courtois-neuromod/controller/README.md

# Game controller for fMRI



This document describes how to build the MR compatible videogame controller developed for the [Courtois Neuromod project](https://www.cneuromod.ca/).

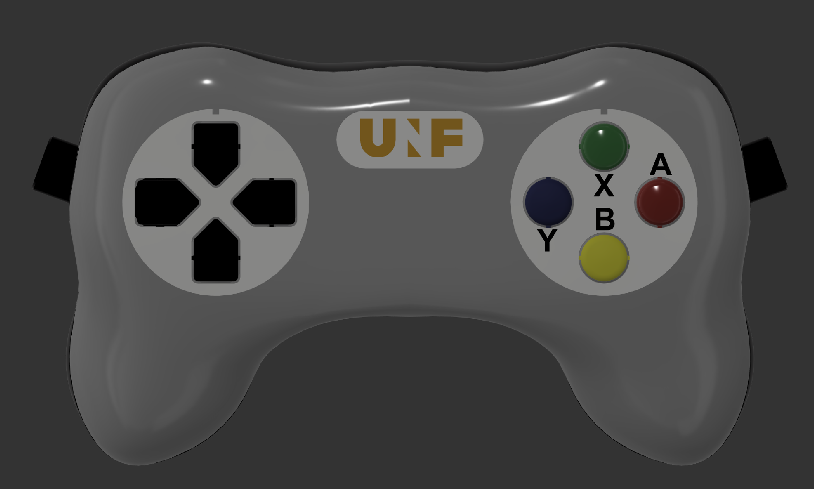
[picture p1: source/_static/body/controller_model.png]
Switch assembly exploded view
