courtois-neuromod/controller/source/BODY.md

# Building the controller body

This document describes the steps necessary to build and assemble the hand-held controller body part.

## Assembly

### Optical switches

#### Shutter assembly

Required:

Parts
  - Shutter_Blade x 8
  - Shutter_Cap x 8
  - Switch_Body x 8

Tools
  - Cyanoacrylate adhesive
  - Fine sanding paper or files
  - X-acto knife

Check both shutter blade and shutter cap for smoothness of surface and file or sand any rough surface. Test insertion of blade into slot at the bottom of shutter cap. It should slide to the bottom easily but you should still feel a bit of resistance. Put a drop of cyanoacrylate adhesive on a liquid tight surface, dip the end of shutter blade in adhesive and insert into slot at bottom of shutter cap.

Shutter assembly drawing | Shutter assembly exemple
---|---
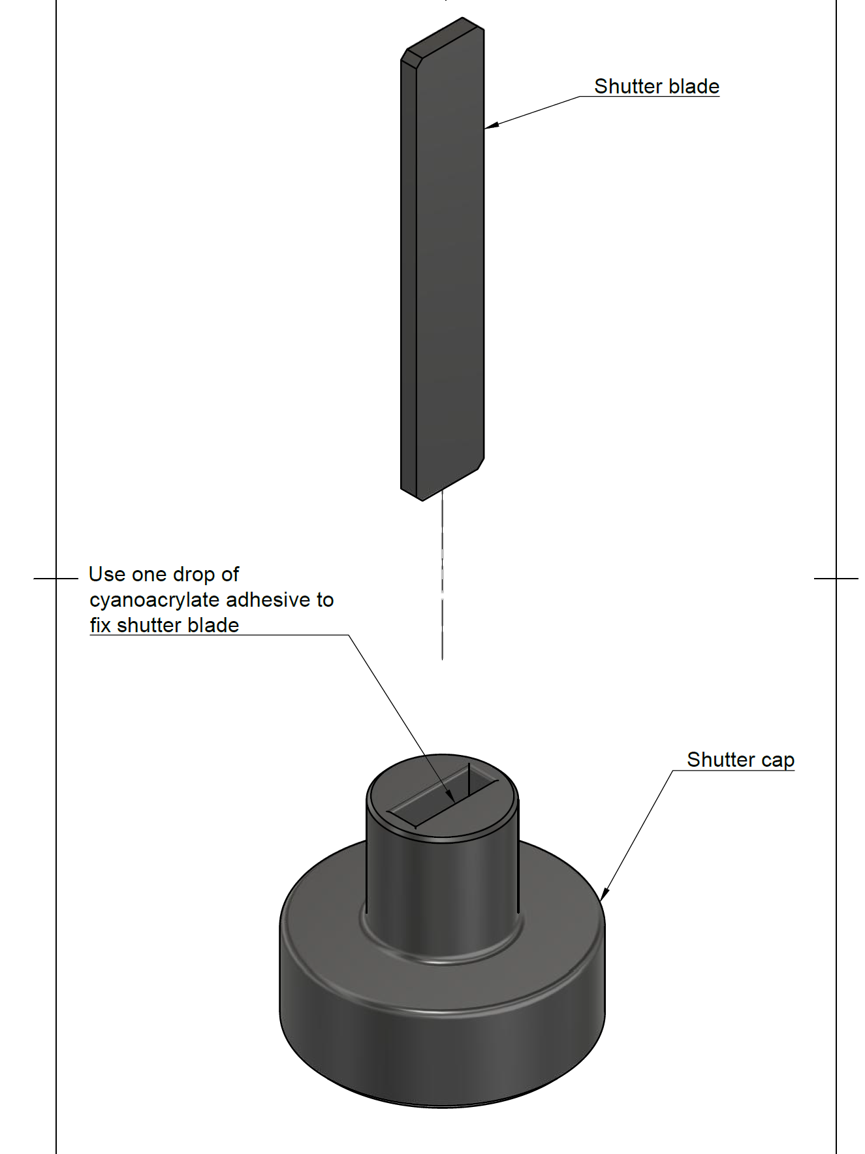
[picture p15: source/_static/body/Shutter_Assembly.png]
Switch assembly exploded view
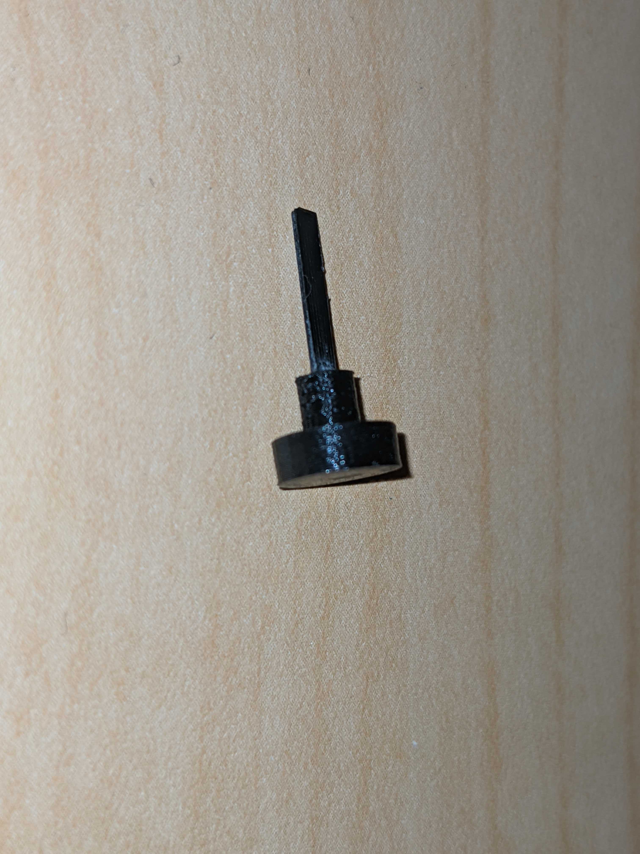
[picture p16: source/_static/body/Shutter_Assembly_demo.jpg]
Switch assembly exploded view
 |

#### Switch assembly

1. Disassemble a discarded computer keyboard to recuperate the membrane making the rubber dome switches. Individually cut away the switch dome parts and remove centre of top surface using an x-acto knife.

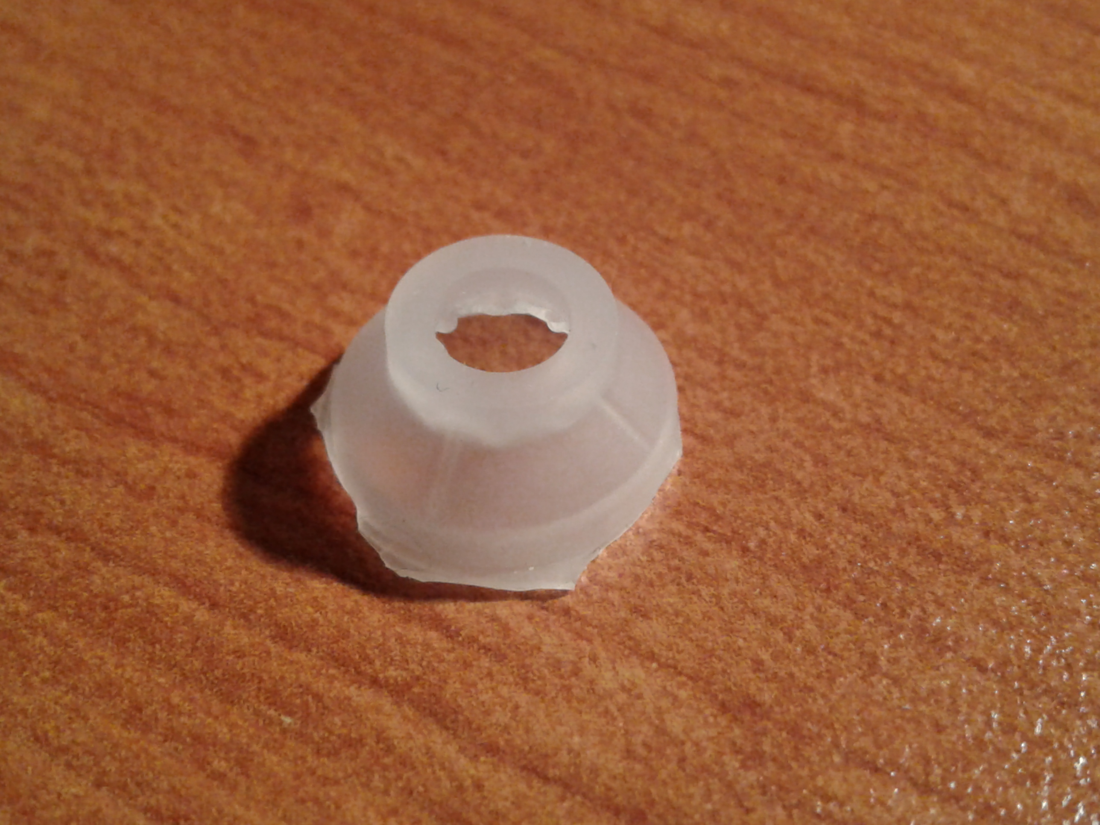
[picture p17: source/_static/body/silicone_membrane.jpg]
Silicone membrane


2. Test assembly of shutter, membrane and switch body by inserting the shutter blade into the empty centre part of rubber dome, then into gap at the top of switch body. The shutter blade should completely occult the guide hole for the fiber optic when button is pressed down, but leave it free when in upward position. The distance between the bottom
 of the shutter cap and the top of switch body will determine the stroke length of the key. The smaller this distance, the more responsive the controls will be. The shutter should move freely up and down.

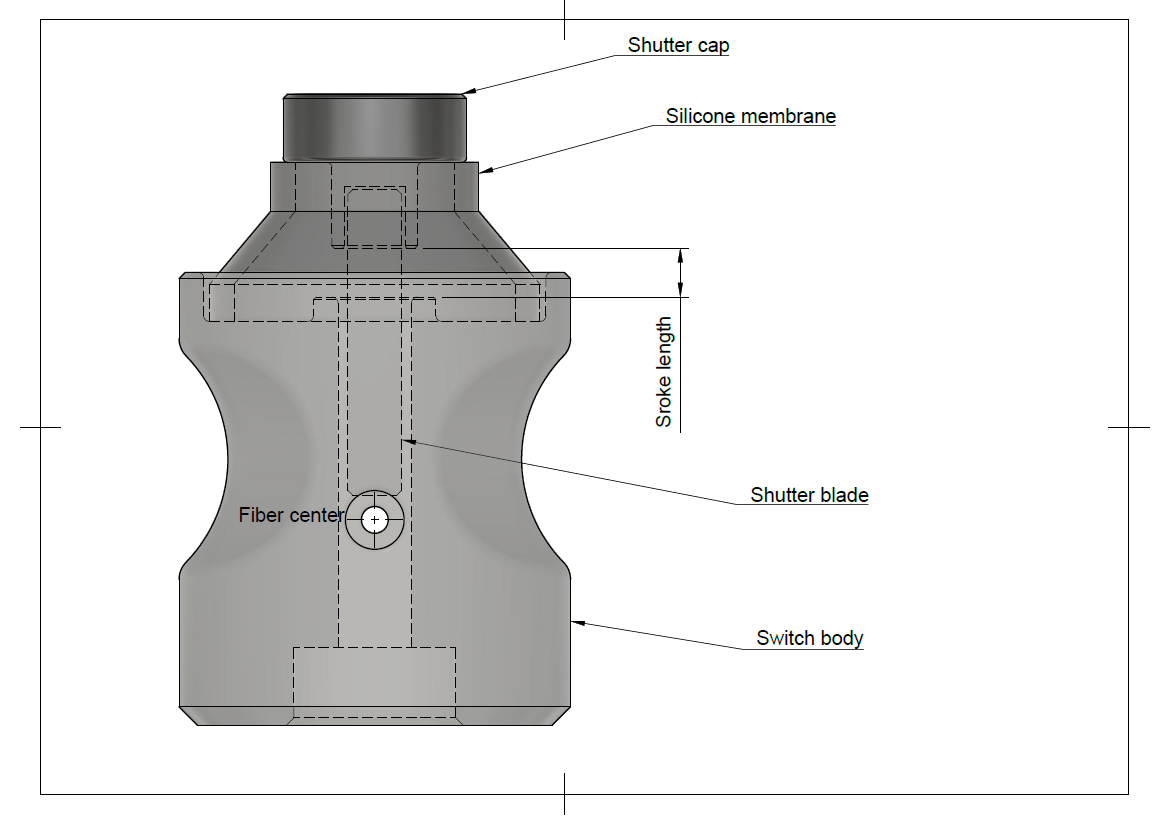
[picture p18: source/_static/body/Switch_Assembly_Drawing.png]
Air Gap Visual Check
 

 Shutter up | Shutter pressed down
 ---|---
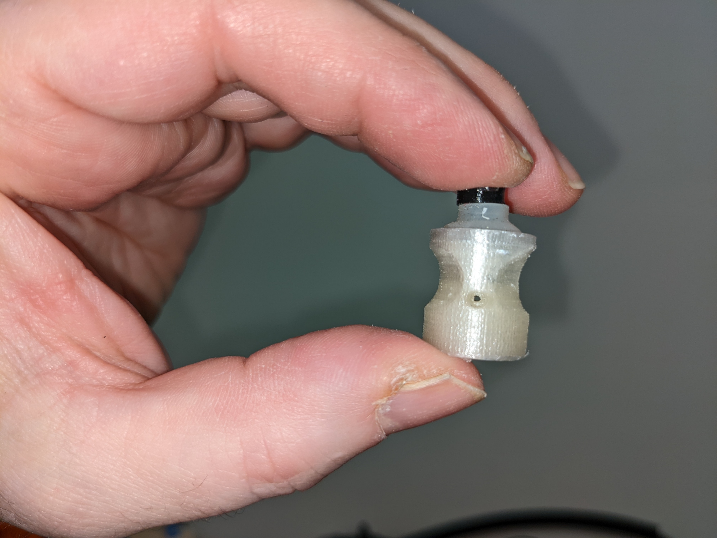
[picture p19: source/_static/body/PXL_20220321_143415461.jpg]
Shutter up
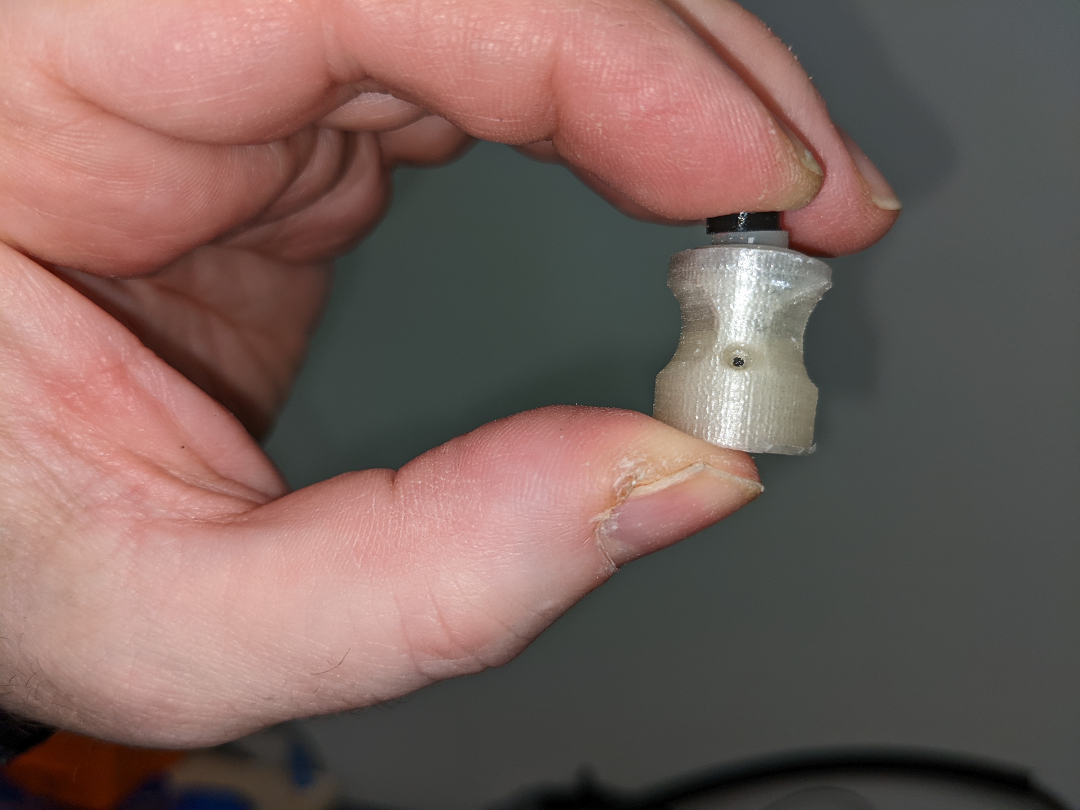
[picture p20: source/_static/body/PXL_20220321_143421189.jpg]
Shutter down
  |

 3. Since the rubber domes recuperated from computer keyboards will very likely vary in dimensions, it might be necessary to modify shutter cap and shutter blade dimensions. The file [Shutter_Assembly_Param.f3d](CAD/f3d/Shutter_Assembly_Param.f3d) contains these two parts in Autodesk Fusion 360 format. The design is parametric to facilitate modifications. To edit the parts, open the file in **Fusion 360**, go to Modify, then select change parameters and expand User Parameters. Changing the value of parameter *Shutter_Cap_Shaft_Length* will allow to adjust the stroke length, while changing *Shutter_Blade_L* will allow ensuring correct shutter operation. That part is also available in [.step](/CAD/stp/Shutter_Cap.step) format for import in other CAD programs.

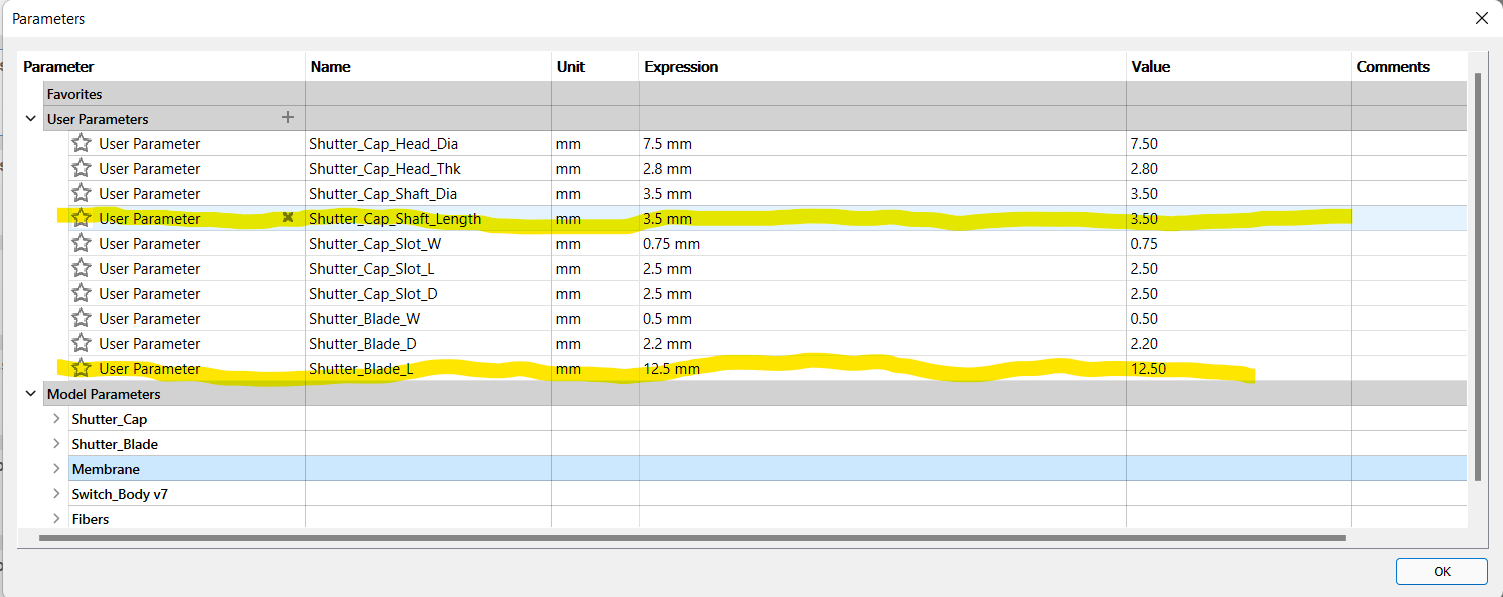
[picture p21: source/_static/body/f3d_screenshot.png]
Parameters edit in Fusion 360
<br>

4. Ensure that the air gap and the fiber optic guide in the 3D printed switch bodies are free of any residual PLA or support material. Hold switch body in front of a light source and check along Z axis for the air gap, and along horizontal axis for the fiber optic guide.

### Controller body

1. For each control on the controller, cut one length of duplex fiber optic to desired length between controller and interface module + 150 mm
2. Split each length of fiber on its length to separate the 2 fibers on a distance of approx. 750 mm from one end, and 25 mm from second end
3. Label each fiber with the name of matching control. On the end where the fibers are split for the largest distance (controller end) place a label on each single fiber
4. On the controller side of the fibers, make two bundles of fibers. Place one fiber of eac78h control in either bundle.
5. For one of the two bundles, cut the fibers for the directional pad controls about 150 mm shorter than the ones for the buttons. Do the opposite with the other bundle. This will allow a cleaner layout of the fibers inside the casing.
6. Strip and polish fibers
7. Cut two 500 mm lengths of the 13 mm ID plastic hose and fix those on the ends of the Y splitter
8. Fix second end of plastic hoses to extrusions on part *Casing_Bottom*

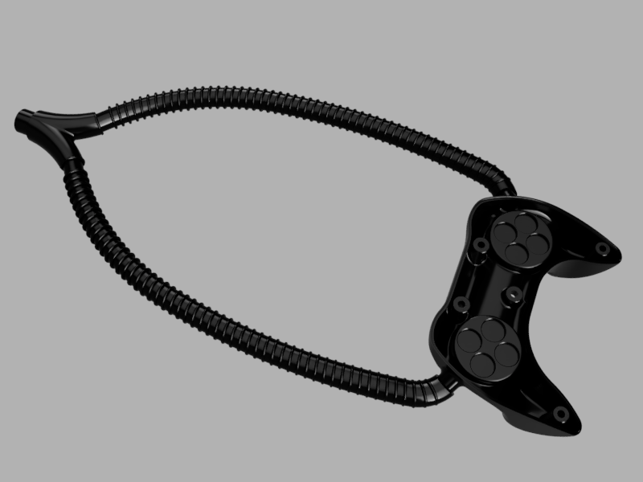
[picture p22: source/_static/body/Fiber_Sheath_Assembly.png]
Fiber_Sheath_Assembly


Fiber_Sheath_Assembly

9. For each control, place a *Switch_Body* in matching groove inside casing.

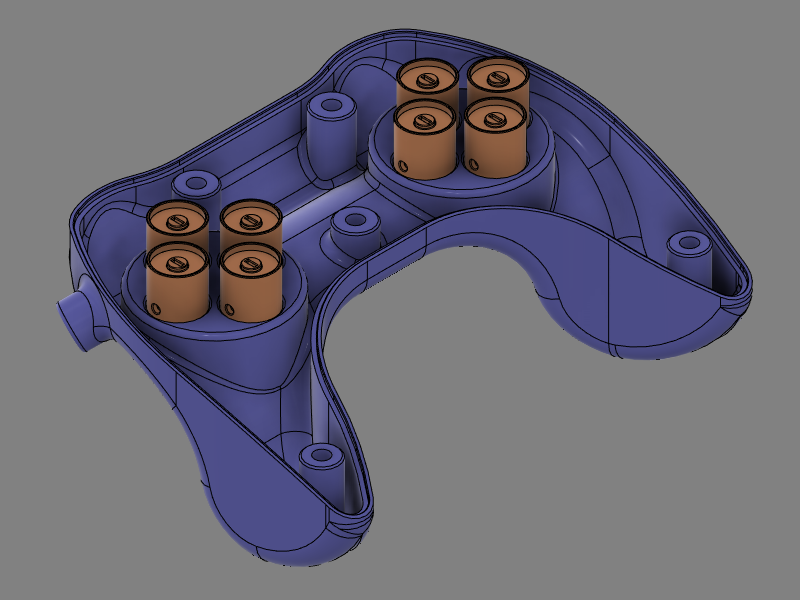
[picture p23: source/_static/body/Switch_Body_Positioning.png]
Switch_Body_Positioning


10. Insert the fiber optics into Y splitter and push gently until both fibers emerge inside of casing. The bundle where the buttons fibers are longer will go on the directional pad side. There will be one fiber for each control in each branch of the Y. Make sure that the length protruding inside the casing is enough to reach into the corresponding *Switch_Module* and allow to lay out cleanly inside casing.
11. For each control, glue both fibers in place **(Need glue specs)**
12. Optional: Depending on fit tightness of *Switch_Module* parts inside grooves, it is also possible to glue the module in place. If gluing modules in place, wait for glue on fibers to set before proceeding
13. Place one threaded Nylon insert in each mounting post of part *Casing_Top*. If inserts don't fit inside, re-drill hole using 1/4" (6.35 mm) bit. If inserts are loose, use a drop of cyanoacrylate adhesive

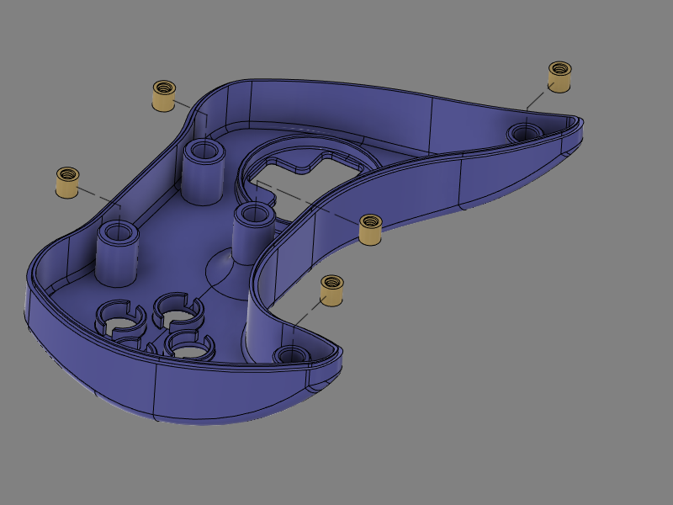
[picture p24: source/_static/body/Threaded_Inserts.png]
Threaded_Inserts
<br>

14. Before starting assembly, test bottom and top parts of casing for fit. The two halves should fit together without any visible gap. Common area that might need post processing are the top and bottom of screw posts and the lip that runs around the perimeter of the bottom part, as well as the matching flat surface on the top part. If necessary, file or sand away excess of material that might prevent case from closing properly.

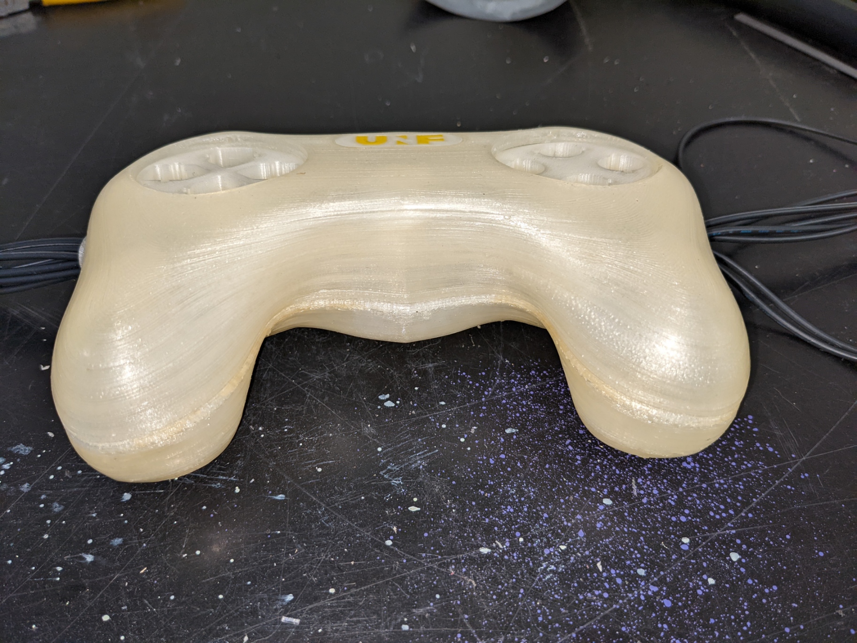
[picture p25: source/_static/body/PXL_20220323_120717804.jpg]
<br>
Test casing for fit

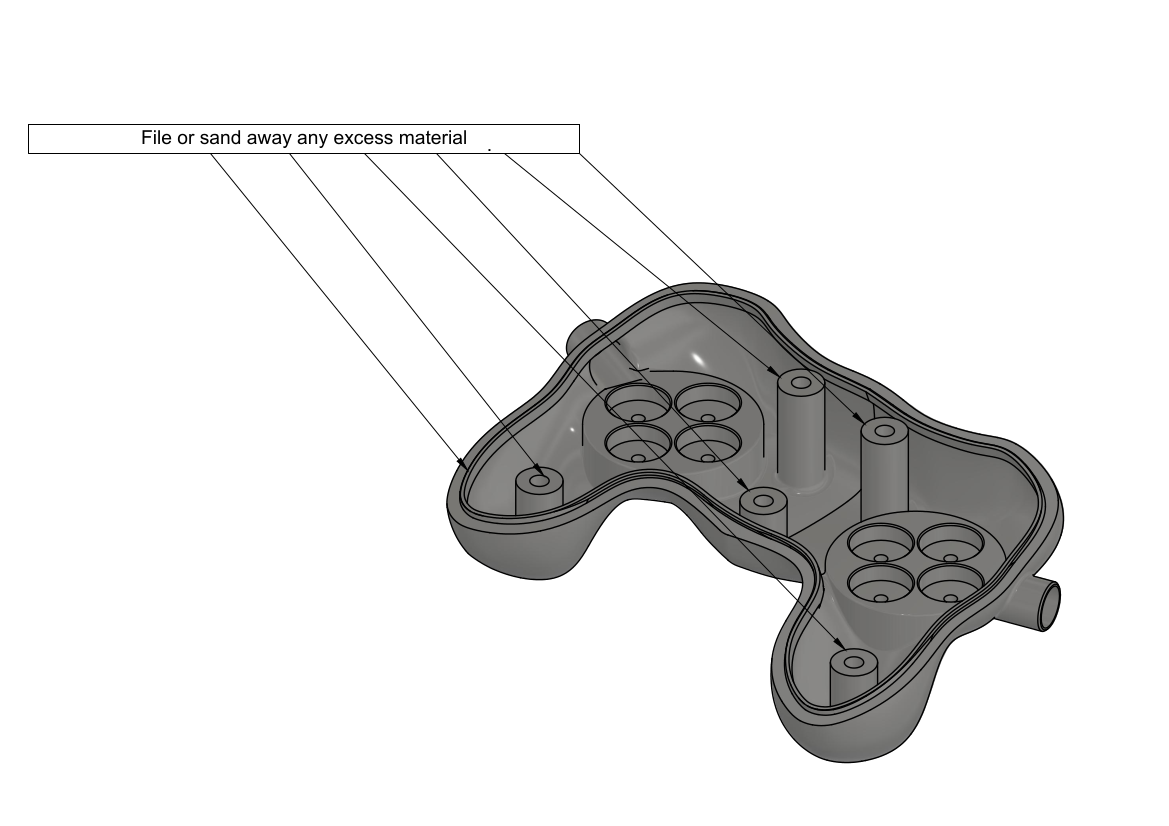
[picture p26: source/_static/body/PostProcess_Bottom.png]
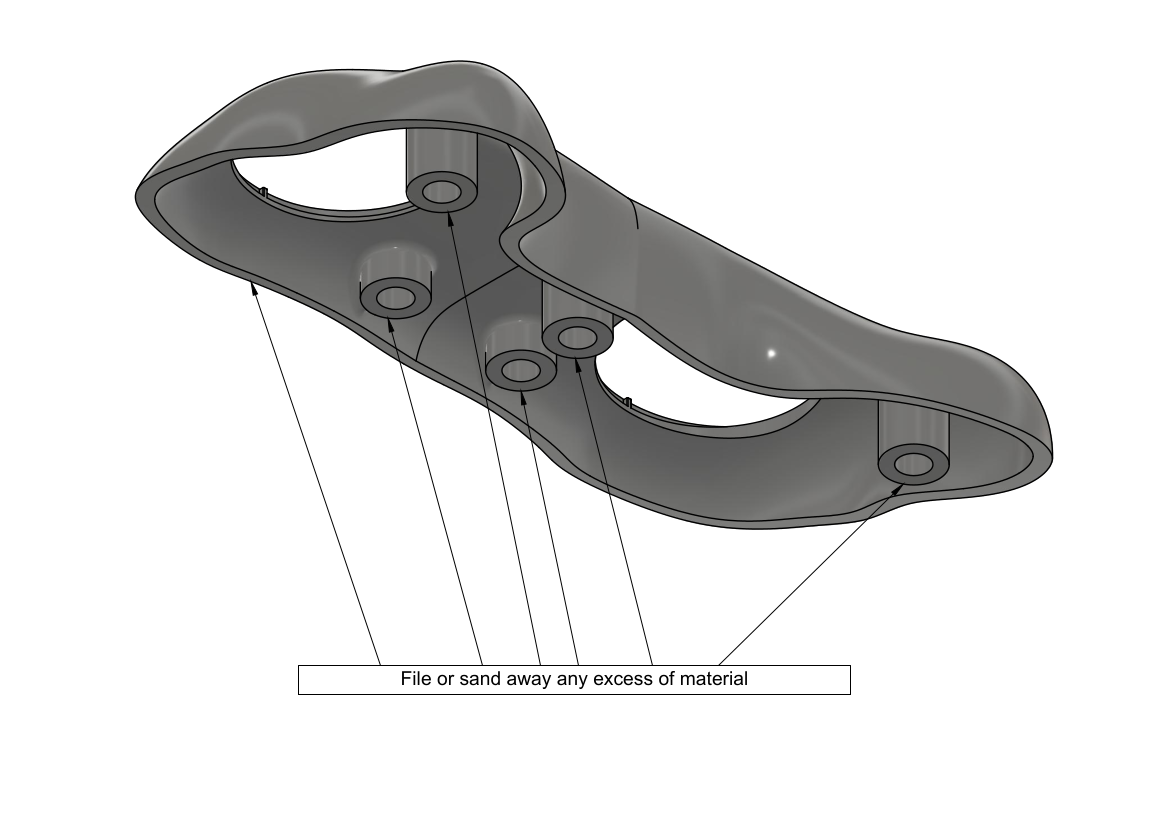
[picture p27: source/_static/body/PostProcess_Top.png]
 |  <br>
Areas commonly requiring post-processing

### Optical fibers assembly
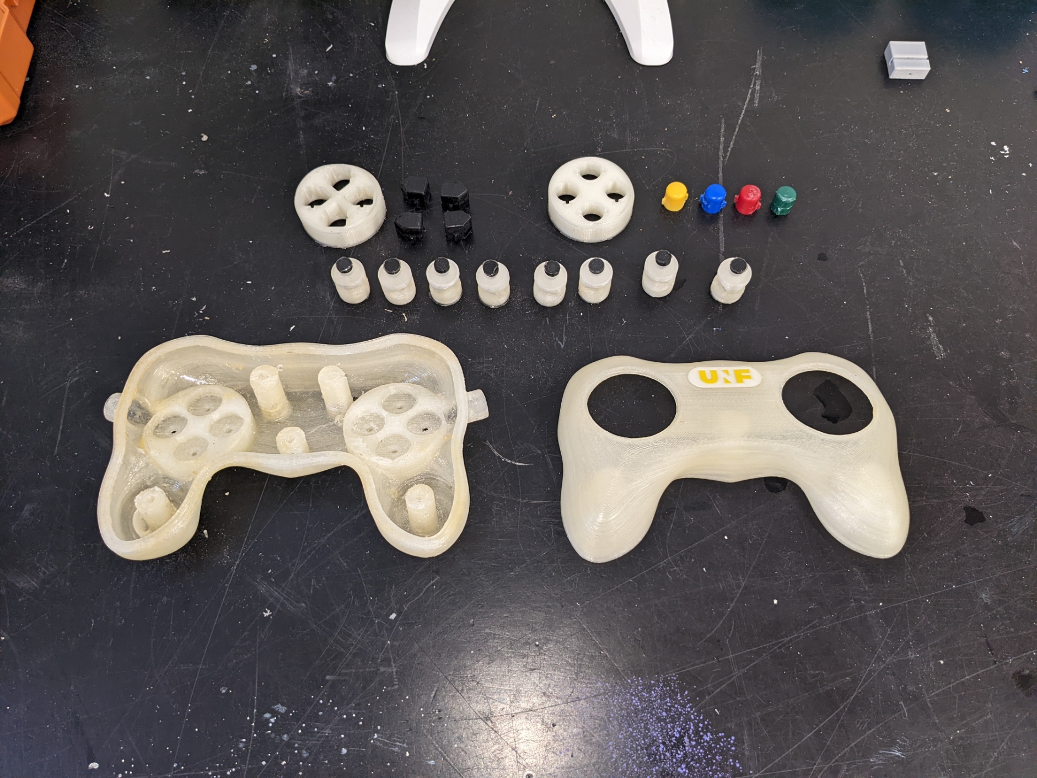
[picture p28: source/_static/body/PXL_20220318_175520012.jpg]
<br>
Parts ready for assembly

1. Separate bundle of fiber optics into two smaller bundles of 8 fibers each. Pull each smaller bundle through the Y splitter with one small bundle coming out of each of the Y branches. Pull each of the smaller bundle into the 1 meter protective sheath until there is approximately 300 mm of fibers coming out of each sheath.

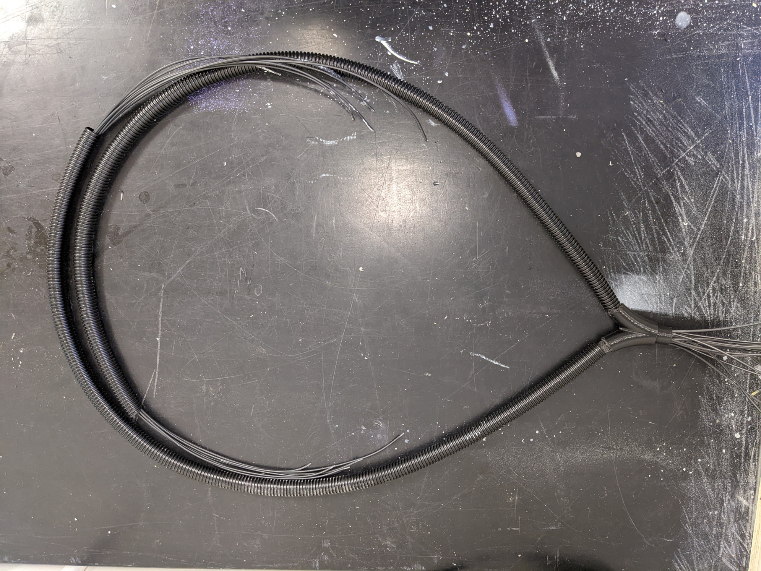
[picture p29: source/_static/body/PXL_20220321_141826371.jpg]
<br>
Separating fibers bundle with Y splitter

2. Pull each bundle into the bottom part of casing through openings on the sides and make sure that the sheaths fit nicely on the protruding parts and that you have at least 200 mm length of fibers going into the casing on both sides.

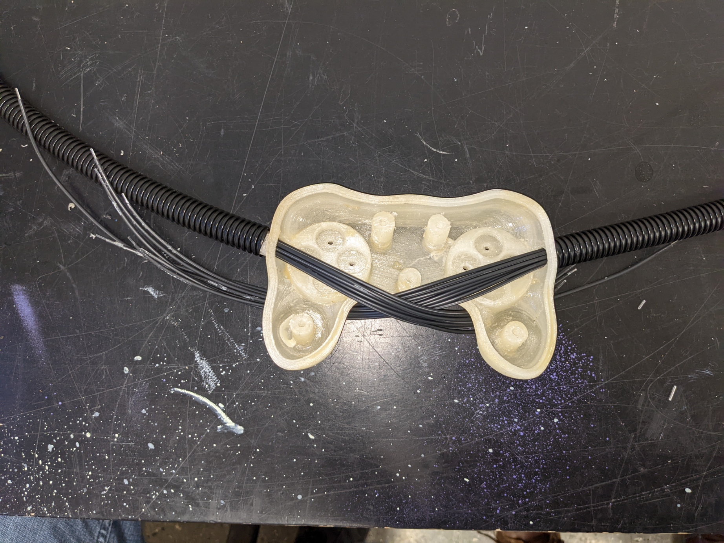
[picture p30: source/_static/body/PXL_20220321_142636964.jpg]
<br>
Fibers insertion in casing

3. Strip fibers and polish the fibers. It's possible to use a regular wire stripping tool set for #18 wire size. Insert fibers into switch body so teh tip of the fiber is flush with the internal wall of the air gap. Ensure that the shutter is free to move after the fibers are in place.
4. Use a drop a glue to affix the fibers to the switch body. The type of glue is not critical, but **do not use** cyanoacrylate or other type of _permanent_ glue. These will work, but they will make the switch impossible to repair, which means in case of a broken fiber or other problem, you will need to replace the whole switch.

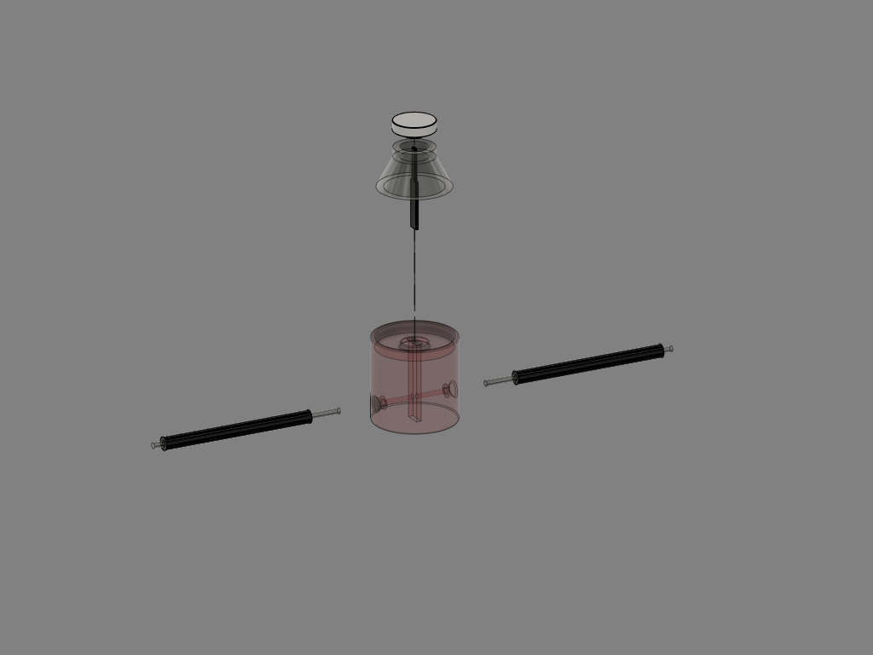
[picture p31: source/img/Switch_exploded.png]
</br>

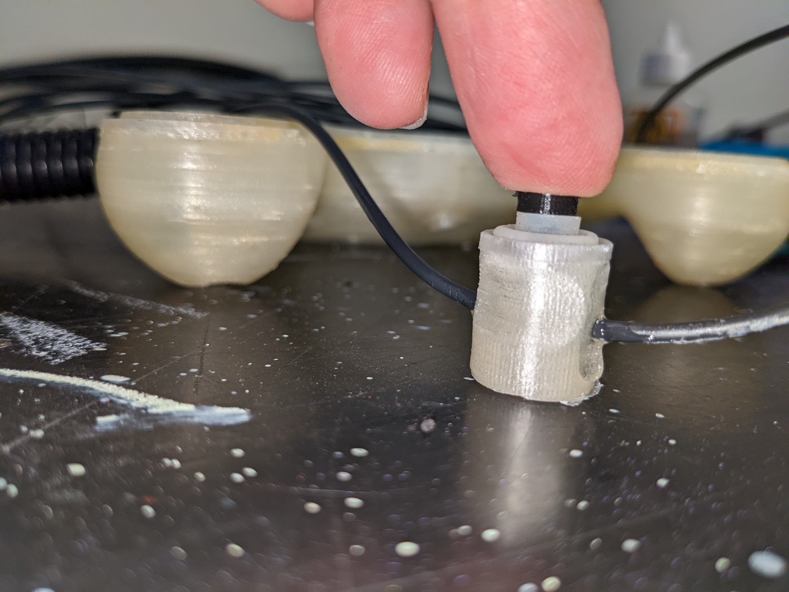
[picture p32: source/_static/body/PXL_20220321_144134479.jpg]
<br>
Fibers connections and testing

5. To assemble the switch inside the casing, it is easier to proceed by pairs, waiting for the glue on the fibers to set before proceeding to the next pair. Proceeding that way allows to move the fibers around to route them cleanly inside the casing without pulling them out from the body of already installed switches. The order is not critical, but it is a lot easier to finish with the pair that's the closest to the opening where the fibers enter the casing.

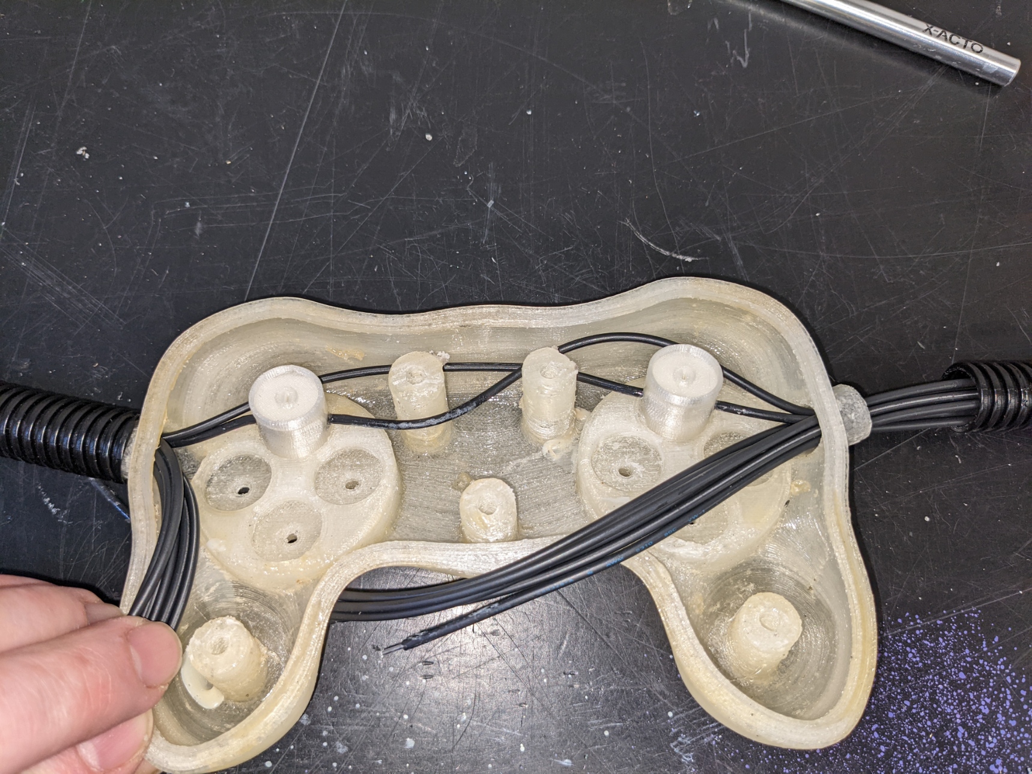
[picture p33: source/_static/body/PXL_20220321_184922653.jpg]
<br>
Assembling first pair of controls

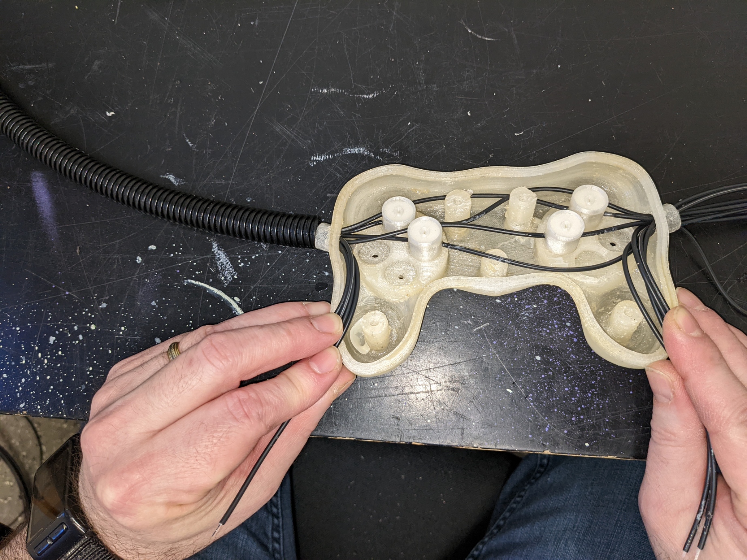
[picture p34: source/_static/body/PXL_20220322_141919955.jpg]
<br>
Assembling second pair of controls

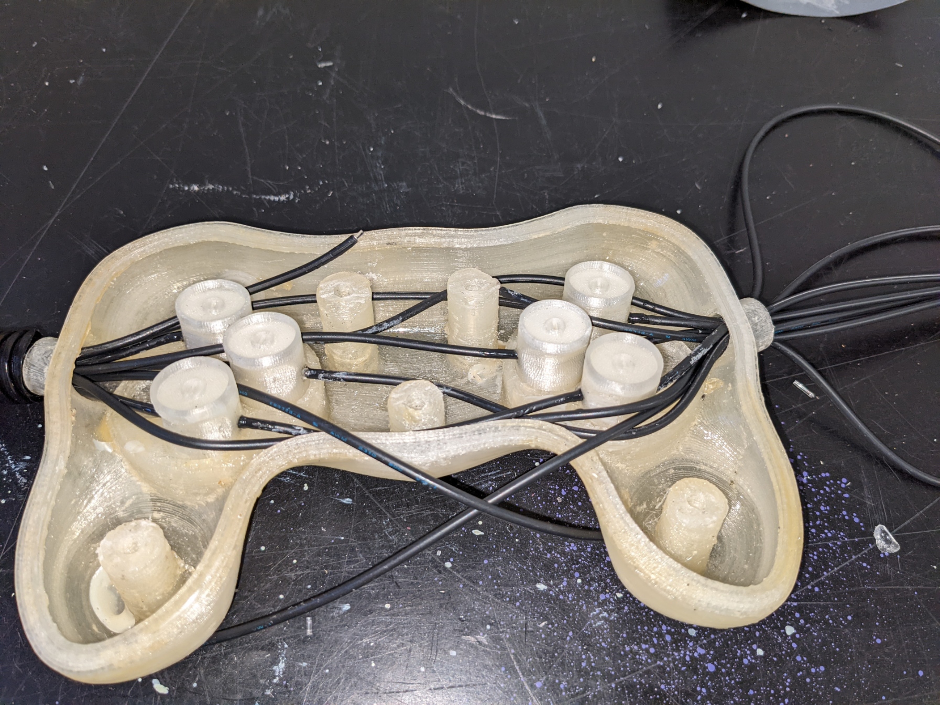
[picture p35: source/_static/body/PXL_20220322_173830800.jpg]
<br>
Assembling third pair of controls

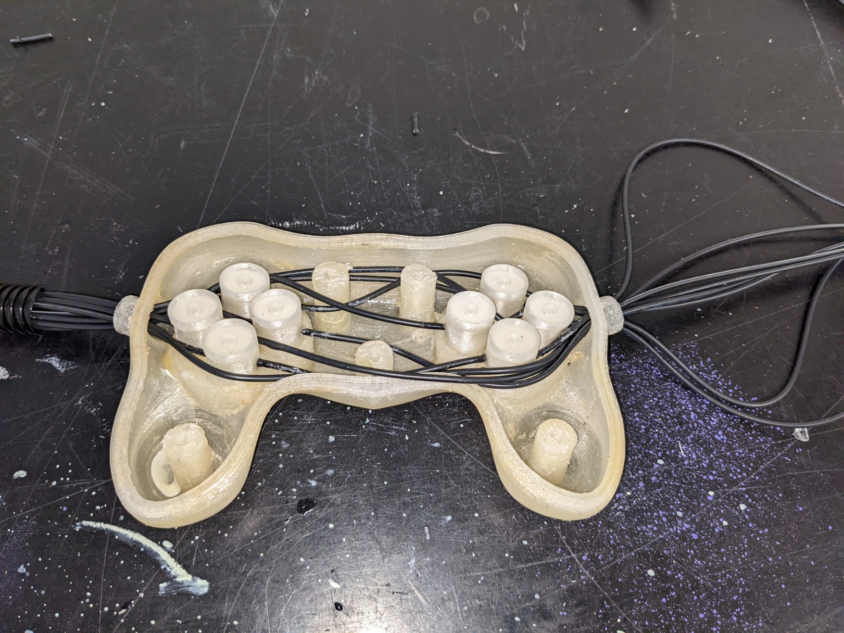
[picture p36: source/_static/body/PXL_20220323_120356872.jpg]
<br>
Assembling fourth pair of controls

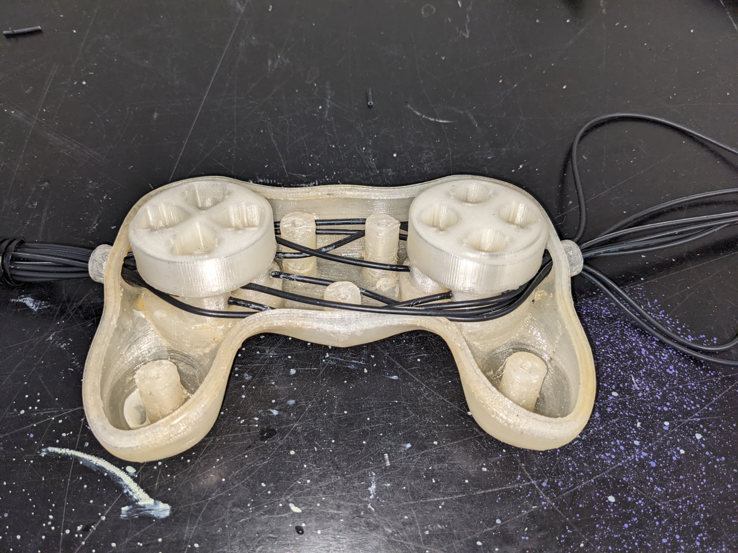
[picture p37: source/_static/body/PXL_20220323_120503073.jpg]
<br>
Add buttons supports

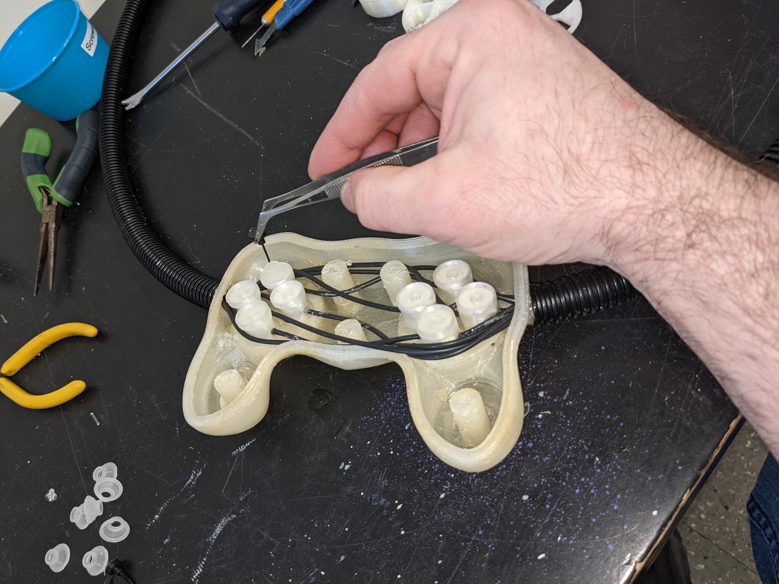
[picture p38: source/_static/body/PXL_20220323_171028876.jpg]
<br>
Installing rubber membranes and shutters

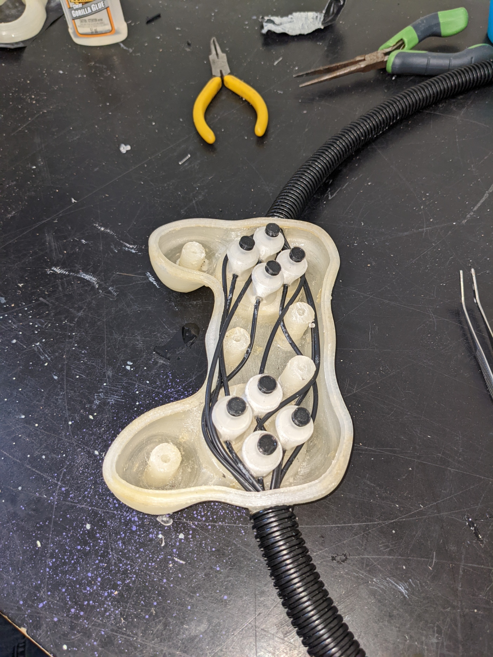
[picture p39: source/_static/body/PXL_20220323_171327664.jpg]
<br>
Finished view

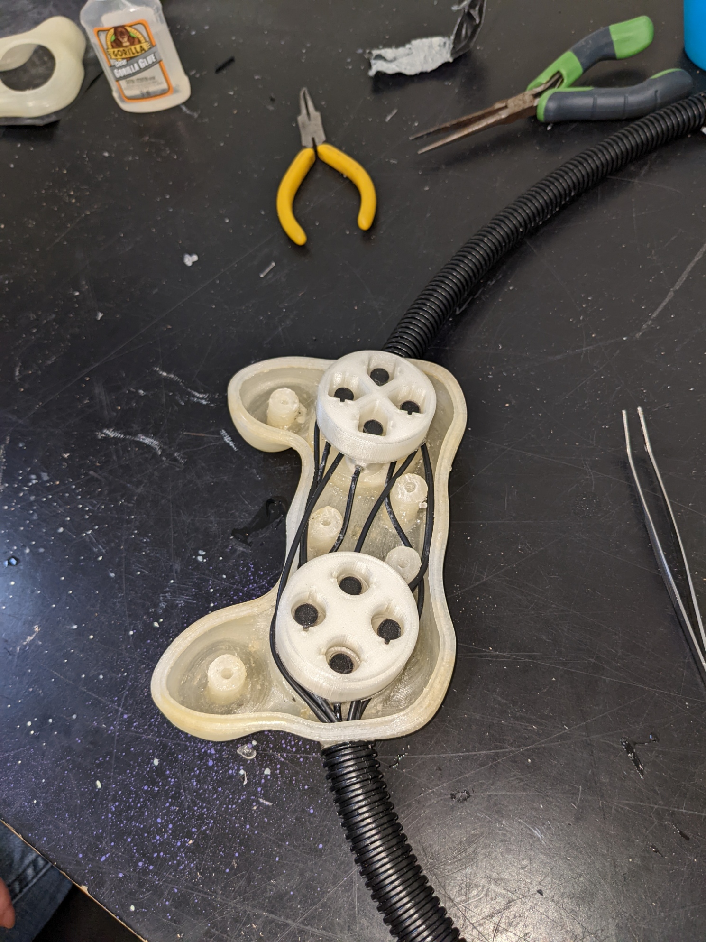
[picture p40: source/_static/body/PXL_20220323_171418885.jpg]
<br>
Re-install buttons supports

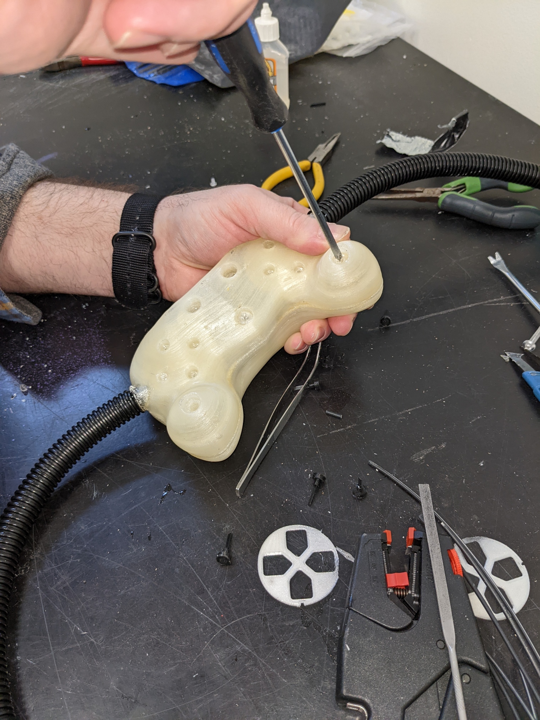
[picture p41: source/_static/body/PXL_20220323_171550344.jpg]
<br>
Close casing

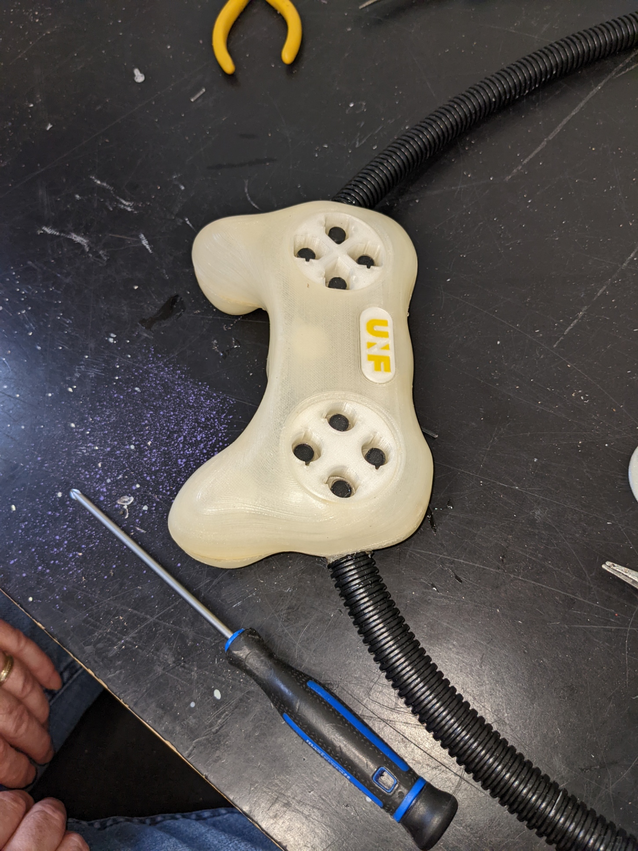
[picture p42: source/_static/body/PXL_20220323_172005029.jpg]
<br>
Casing closed top view

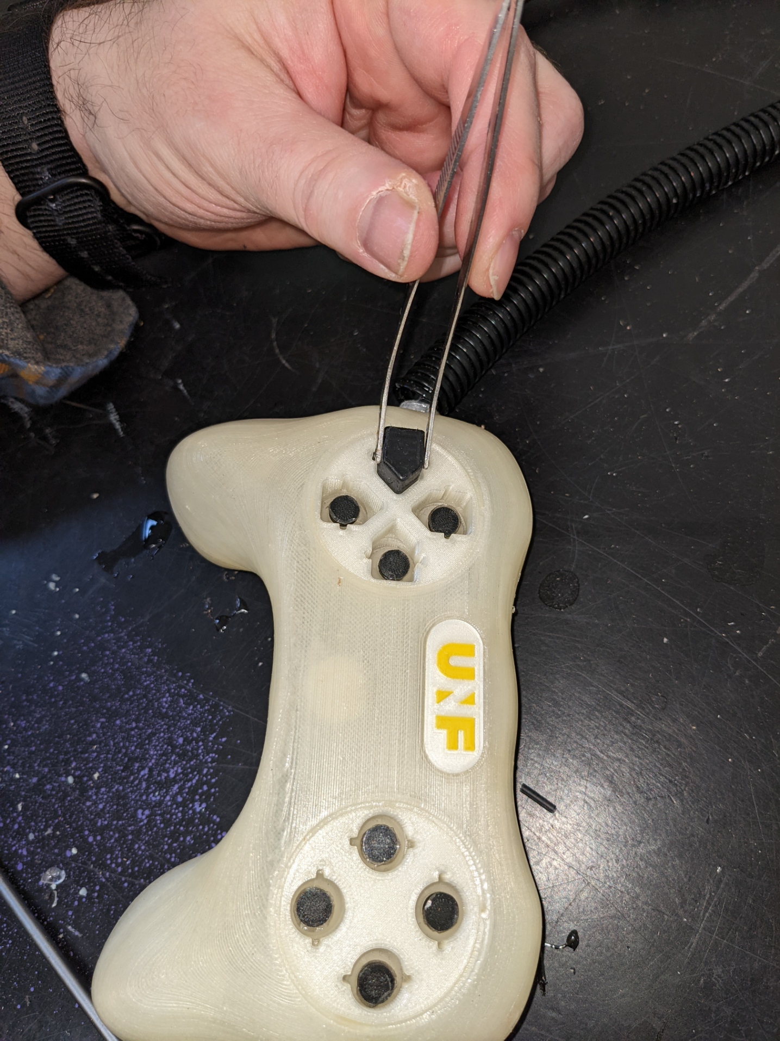
[picture p43: source/_static/body/PXL_20220323_172037025.jpg]
<br>
Install buttons

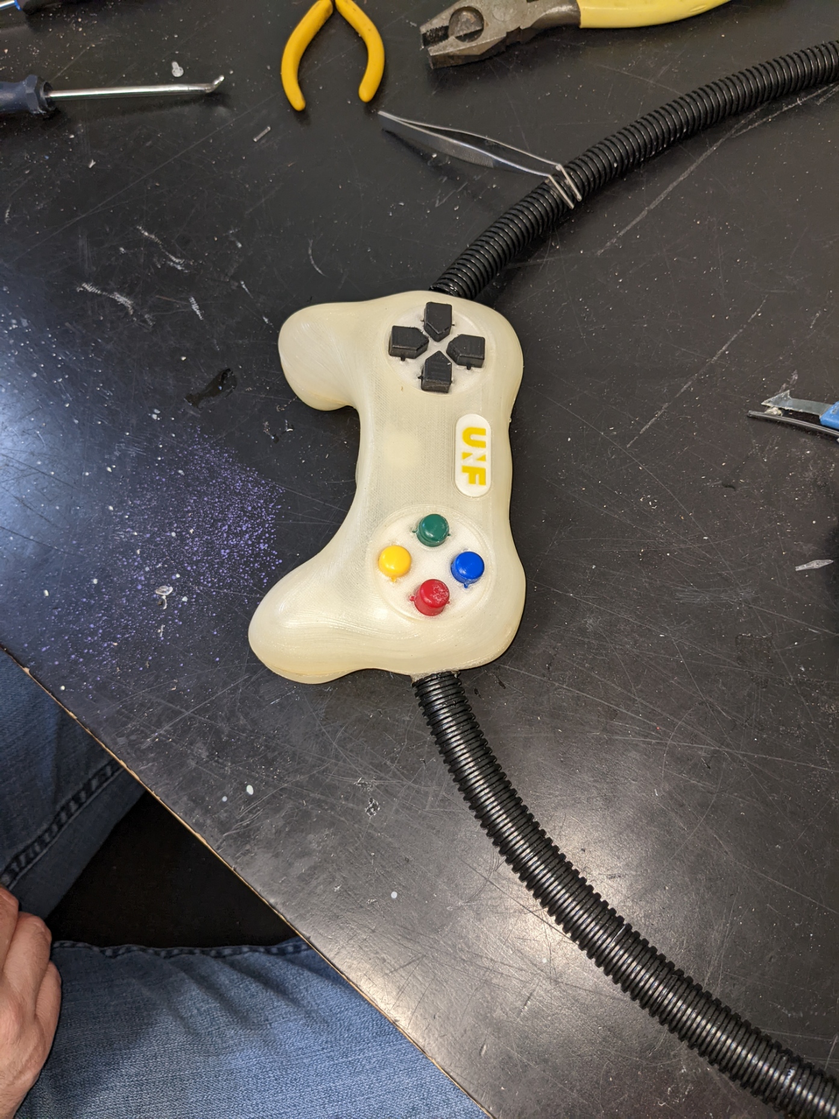
[picture p44: source/_static/body/PXL_20220323_172241888.jpg]
<br>
Finished view

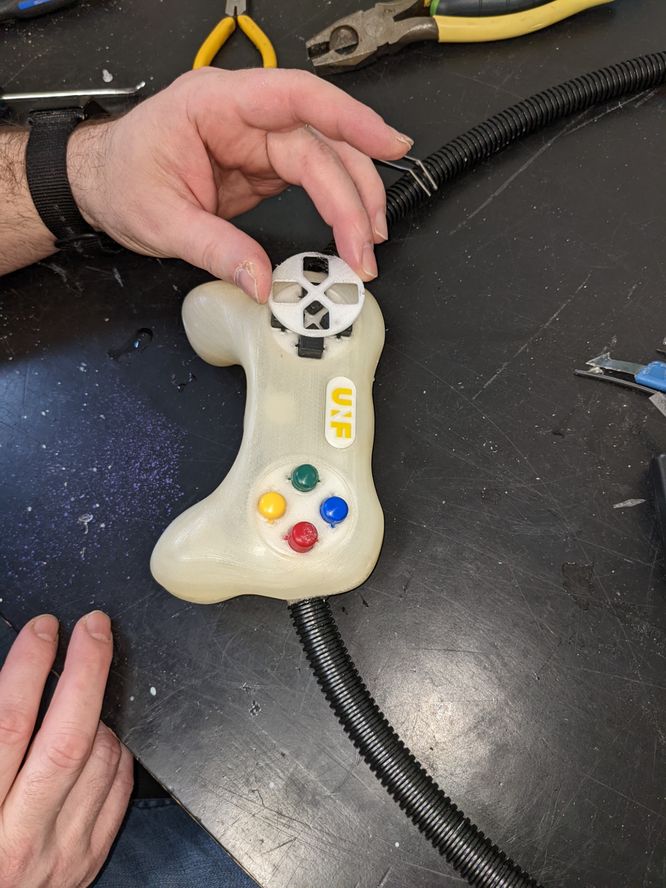
[picture p45: source/_static/body/PXL_20220323_172252091.jpg]
<br>
Install direction pad cover and buttons cover

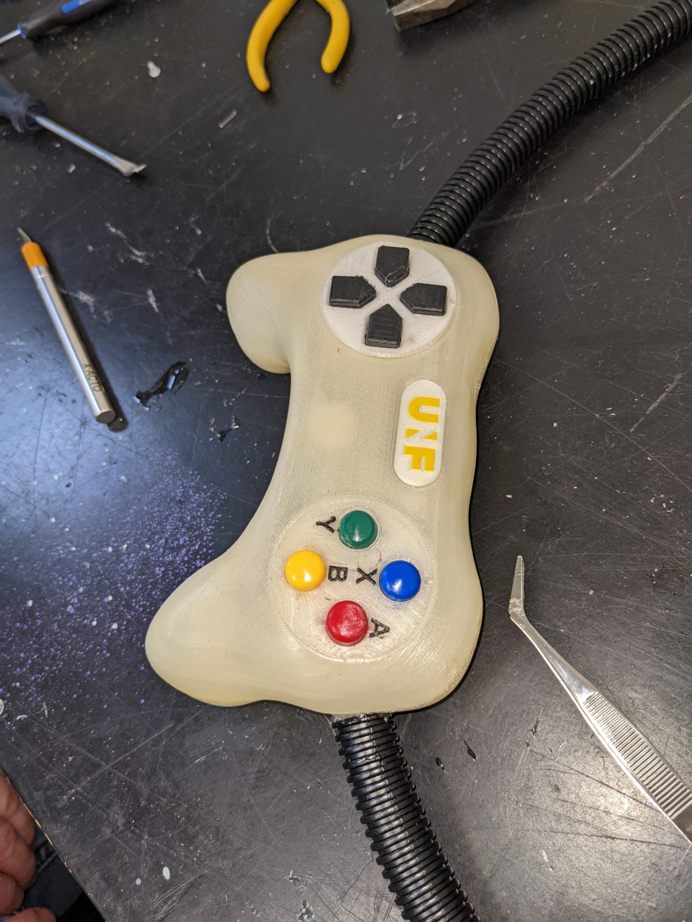
[picture p46: source/_static/body/PXL_20220323_173032643.jpg]
<br>
Assembly complete
