courtois-neuromod/controller/source/img/330Ohms.png

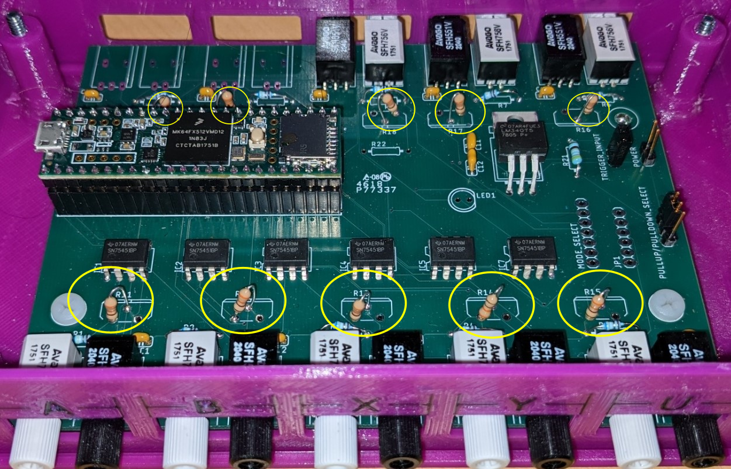
source/img/330Ohms.png
