courtois-neuromod/controller/source/img/75451.png

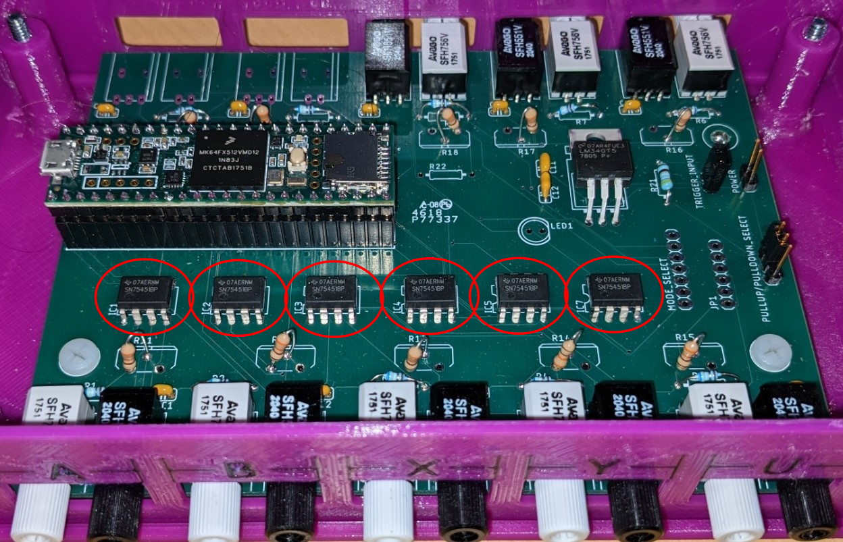
source/img/75451.png
