courtois-neuromod/controller/source/img/SFH551.png

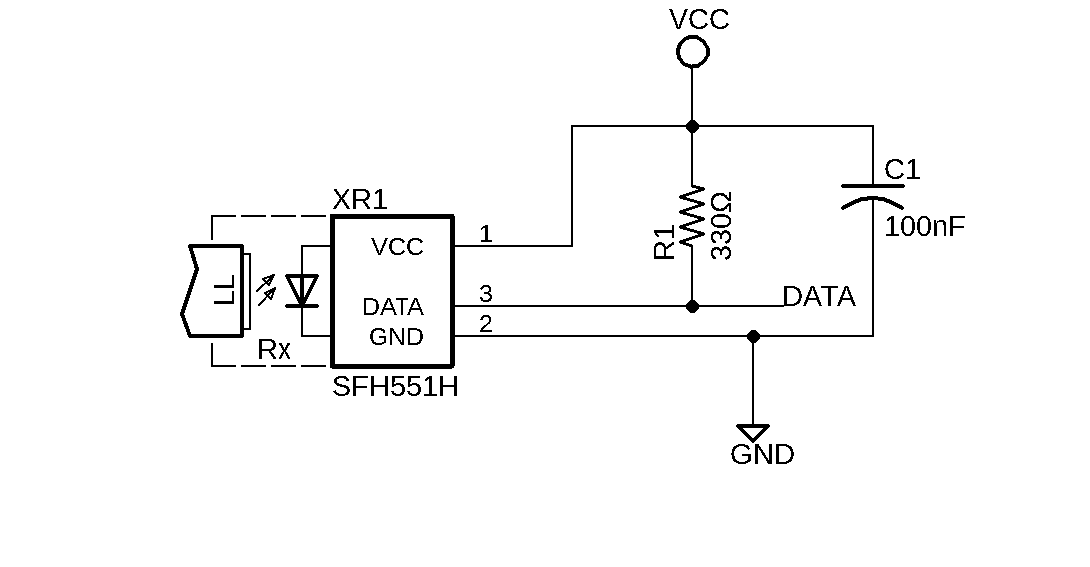
source/img/SFH551.png
