courtois-neuromod/controller/source/img/SFH756.png

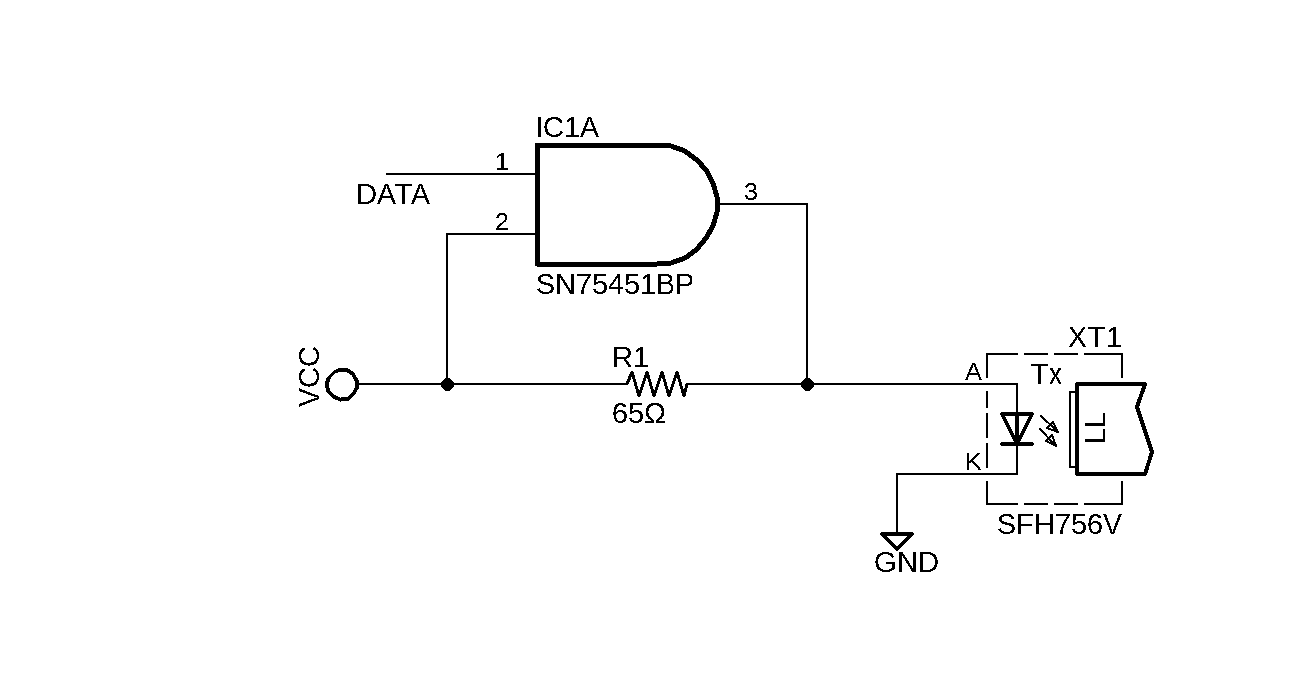
source/img/SFH756.png
