courtois-neuromod/controller/source/BOM.md

# Bill of material

This section lists the commercially available parts needed to build the controller. At the time of building, these could be obtained for slightly less than $1000 CAD. When available, the manufacturer's part number is also given to facilitate finding the parts from other suppliers.

Part | Supplier | Manufacturer part no. | Supplier part no. | Qty
-----|----------|-----------------------|-------------------|-
**Electronics**
Fiber optic cable duplex 100m  | Digikey | HFBR-RUD100Z | [516-2093-ND](https://www.digikey.ca/en/products/detail/broadcom-limited/HFBR-RUD100Z/1990491) | 1
Fiber optic transmitter | Digikey | SP000063814 | [516-2213-ND](https://www.digikey.ca/en/products/base-product/broadcom-limited/516/SP000063814/298985)| 8
Fiber optic receiver | Digikey | SP000063855 | [516-2455-ND](https://www.digikey.ca/en/products/base-product/broadcom-limited/516/SP000063855/298987) | 8
Teensy 3.5 microcontroller board<br>**It is important to use version 3.5 and not 3.6.<br>I/O pins on 3.6 are not 5V tolerant** | Digikey |DEV-14055 | [1568-1443-ND](https://www.digikey.ca/en/products/detail/sparkfun-electronics/DEV-14055/6235191)  | 1
Gate driver | Digikey | SN75451BP | [296-1746-5-ND](https://www.digikey.ca/en/products/detail/texas-instruments/SN75451BP/277392) | 5
Hose 13mm ID, black PE <sup>1</sup>|Digikey|CLTS50F-C|[298-13576-ND](https://www.digikey.ca/en/products/detail/panduit-corp/CLTS50F-C/4567741) | 1
Hose 19.48mm ID, black PE <sup>1</sup>|Digikey|CLTS75F-C|	[298-13577-ND](https://www.digikey.ca/en/products/detail/panduit-corp/CLTS75F-C/4567748) | 1
Voltage regulator | Digikey |LM7805CT/NOPB | [296-47192-ND](https://www.digikey.ca/en/products/detail/texas-instruments/LM7805CT-NOPB/3901929) | 1
Resistor 330 Ω | Digikey | ROX1SJ330R | 	[A131459CT-ND](https://www.digikey.ca/en/products/detail/te-connectivity-passive-product/ROX1SJ330R/8603589) | 8 |
Resistor 65 Ω | Digikey | SFR16S0006499FR500 | 	[PPC64.9XCT-ND](https://www.digikey.ca/en/products/detail/vishay-beyschlag-draloric-bc-components/SFR16S0006499FR500/594439) | 8 |
Capacitor ceramic 0.1 µF | Digikey | C315C104M5U5TA | 	[399-4151-ND](https://www.digikey.ca/en/products/detail/kemet/C315C104M5U5TA/817927) | 8 |
Capacitor ceramic 10 µF | Digikey | C324C106K3R5TA | 	[399-13950-ND](https://www.digikey.ca/en/products/detail/kemet/C324C106K3R5TA/6562361) | 2 |
Connector header pin breakaway 24 pos | Digikey | 4-102972-0-24 | 	[A26519-24-ND](https://www.digikey.ca/en/products/detail/te-connectivity-amp-connectors/4-102972-0-24/683577) | 4 |
Connector receptacle 24 pos | Digikey | 929850-01-24-RA | 	[929850E-01-24-ND](https://www.digikey.ca/en/products/detail/3m/929850-01-24-RA/1094205) | 2 |
**Hardware**
Polycarbonate Pan Head Philips Screw 8-32 x 1" <sup>2</sup> | McMaster-Carr| |[93140A782](https://www.mcmaster.com/93140A782) | 2
Polycarbonate Pan Head Philips Screw 8-32 x 1/2" <sup>2</sup> | McMaster-Carr | |[93140A588](https://www.mcmaster.com/93140A588)| 3
Polycarbonate Pan Head Philips Screw 4-40 x 3/16" <sup>3</sup> | McMaster-Carr | | [93140A403](https://www.mcmaster.com/93140A403)| 8
Nylon 6/6 Female Threaded Round Standoff 8-32 x 1/4" <sup>2</sup> | McMaster-Carr| |[96110A026](https://www.mcmaster.com/96110A026)| 5
Nylon 6/6 Female Threaded Round Standoff 4-40 x 1/8" <sup>3</sup>| McMaster-Carr| |[96110A001](https://www.mcmaster.com/96110A001)| 8

1. Optional
2. Metric equivalent M4 thread
3. Metric equivalent M2.5 thread
