courtois-neuromod/controller/build/html/_static/download/stp/Shutter_Cap.step

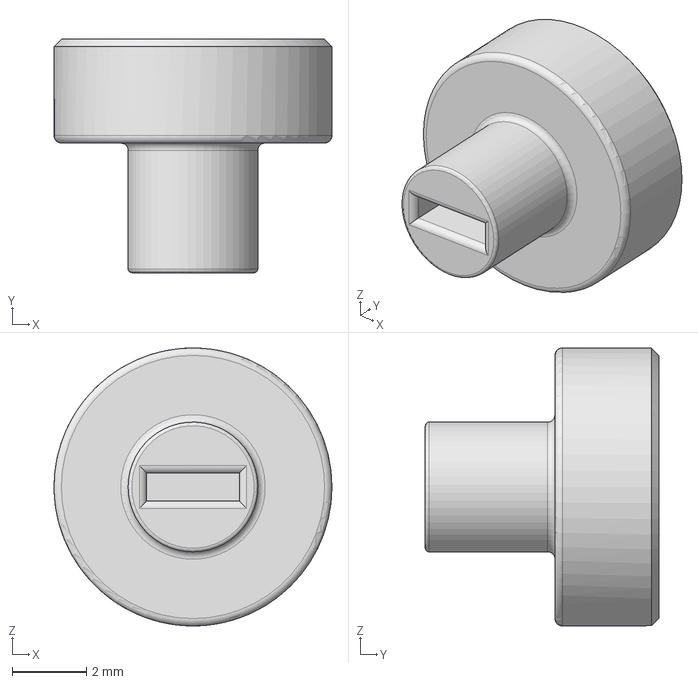
[picture p61: CAD file, 2022-08-26]
build/html/_static/download/stp/Shutter_Cap.step
7.50 x 6.30 x 7.50 mm
