courtois-neuromod/controller/(list of files, cad)

Other CAD files:
build/html/_static/download/f3d/Shutter_Assembly_Param.f3d
