courtois-neuromod/controller/build/html/_static/download/f3d/readme.md

This folder contains native CAD files for the project. The controller was designed with Autodesk Fusion 360.

List of files:

- [Controller assembly](Videogame_Controller_V5.f3z)
- [Parametric design for the shutter part](Shutter_Assembly_Param v1.f3d)
