courtois-neuromod/controller/build/html/_static/body/PXL_20220318_175434145.jpg

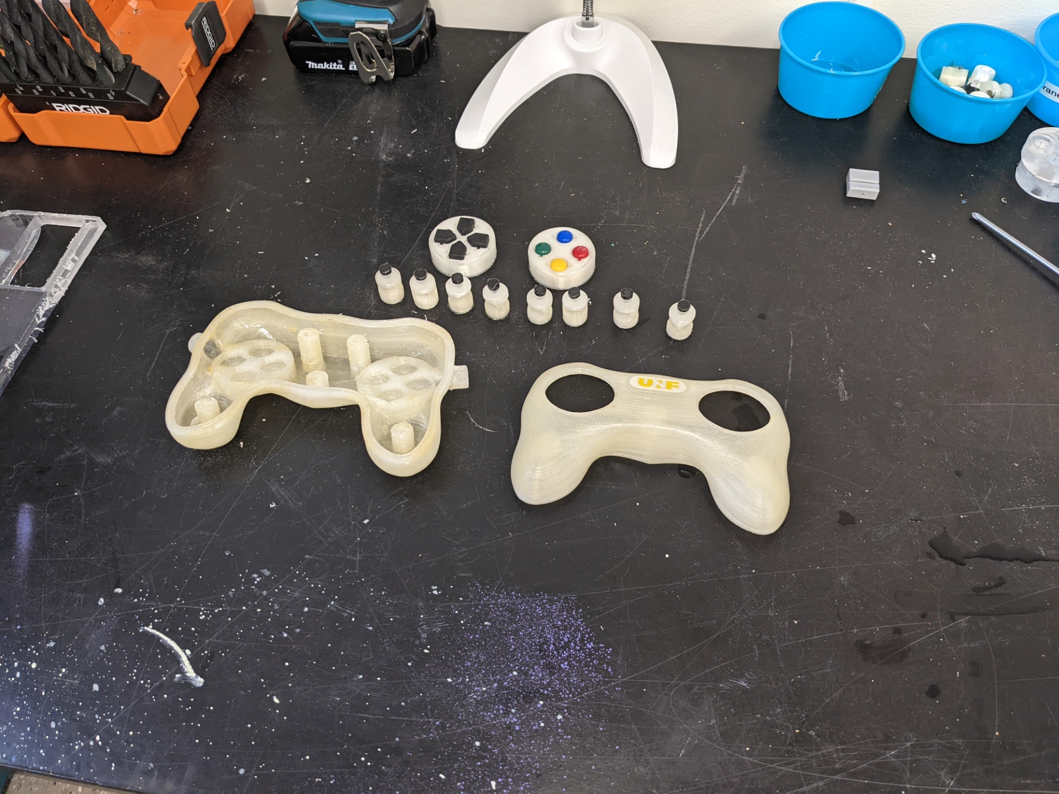
build/html/_static/body/PXL_20220318_175434145.jpg
