courtois-neuromod/controller/source/img/Casing_Assembly.png

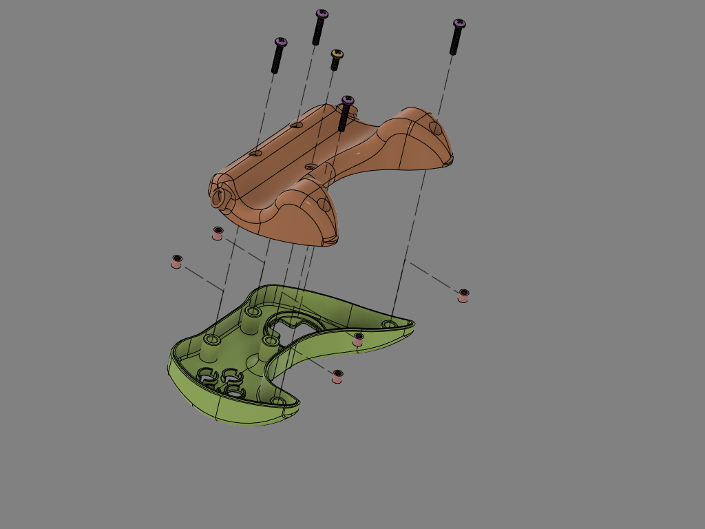
source/img/Casing_Assembly.png
