courtois-neuromod/controller/source/img/DPad_assembly.png

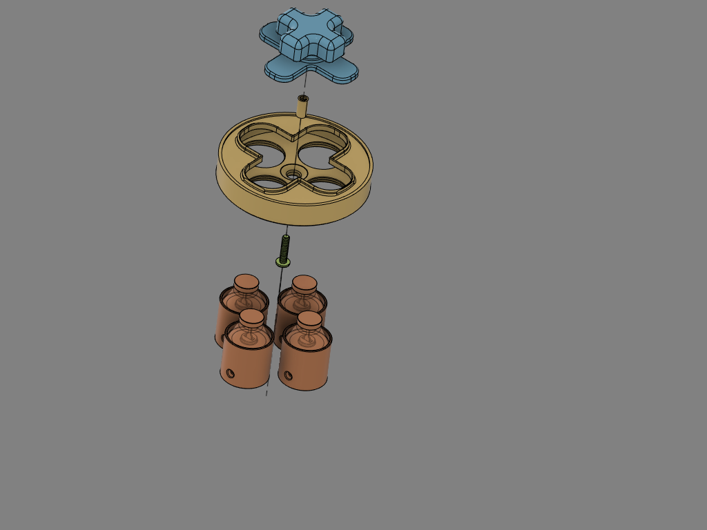
source/img/DPad_assembly.png
