courtois-neuromod/controller/source/img/Switch_assembly_1.png

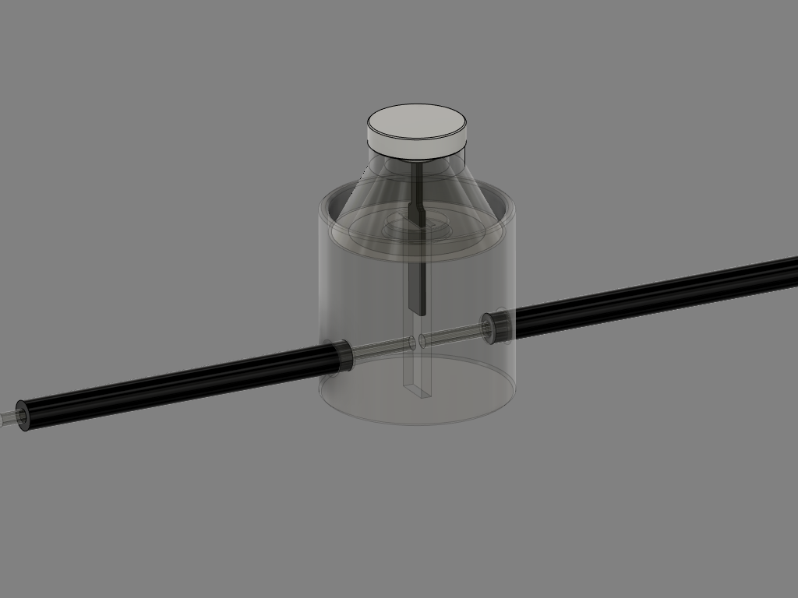
source/img/Switch_assembly_1.png
