courtois-neuromod/controller/build/html/_static/body/PostProcess_Bottom.pdf

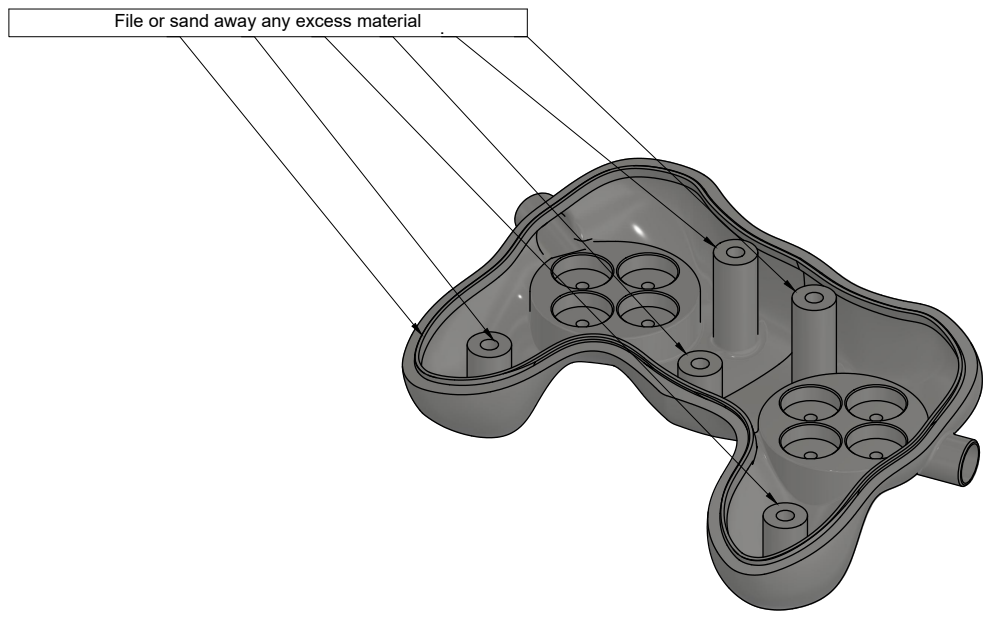
[picture p66: page 1]

File or sand away any excess material .
