courtois-neuromod/controller/build/html/_static/body/PostProcess_Top.pdf

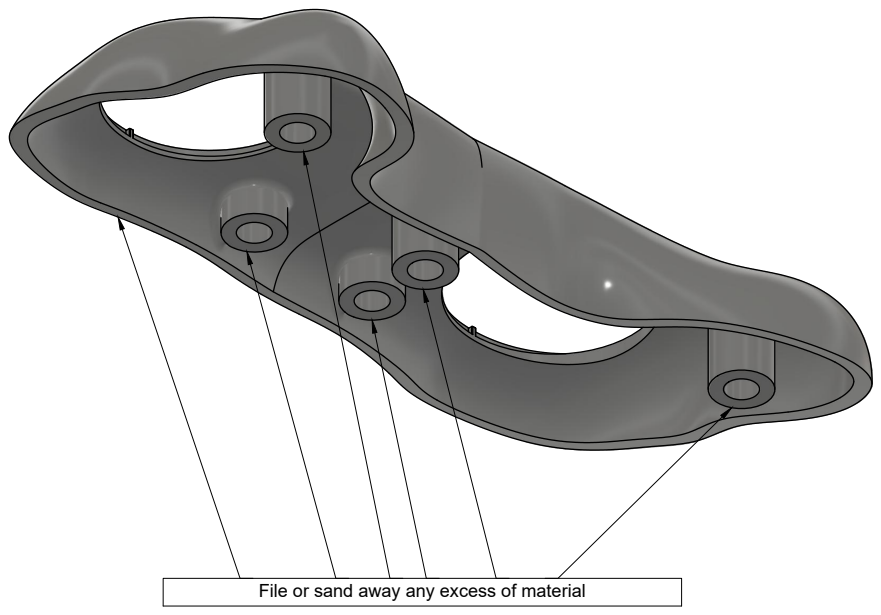
[picture p67: page 1]

File or sand away any excess of material
