courtois-neuromod/controller/(commit log)

2022-08-26 mv img to _static/PCB
2022-08-26 add teensy content
2022-08-26 format code in teensy content
2022-08-26 add pic of teensy cfg
2022-08-26 add bom content
2022-08-26 edit BOM: remove mfg and price
2022-08-26 bom - edit nb list
2022-08-26 Add BOM descr paragraph
2022-08-26 edit BOM intro
2022-08-26 add cad files
    [Shutter_Assembly_Param.f3d, Shutter_Cap.step]
2022-08-26 links t o download
    [Shutter_Assembly_Param.f3d, Shutter_Cap.step]
2022-08-26 update links in PCB
2022-09-02 add warning for Teensy version
2022-10-21 edit teensy.md
2023-01-31 add circuit schematics
2023-03-09 Fix issue with floating trigger pin
